Noe-NoserYoung/uek216/uek216/docs/verdrahtung.png

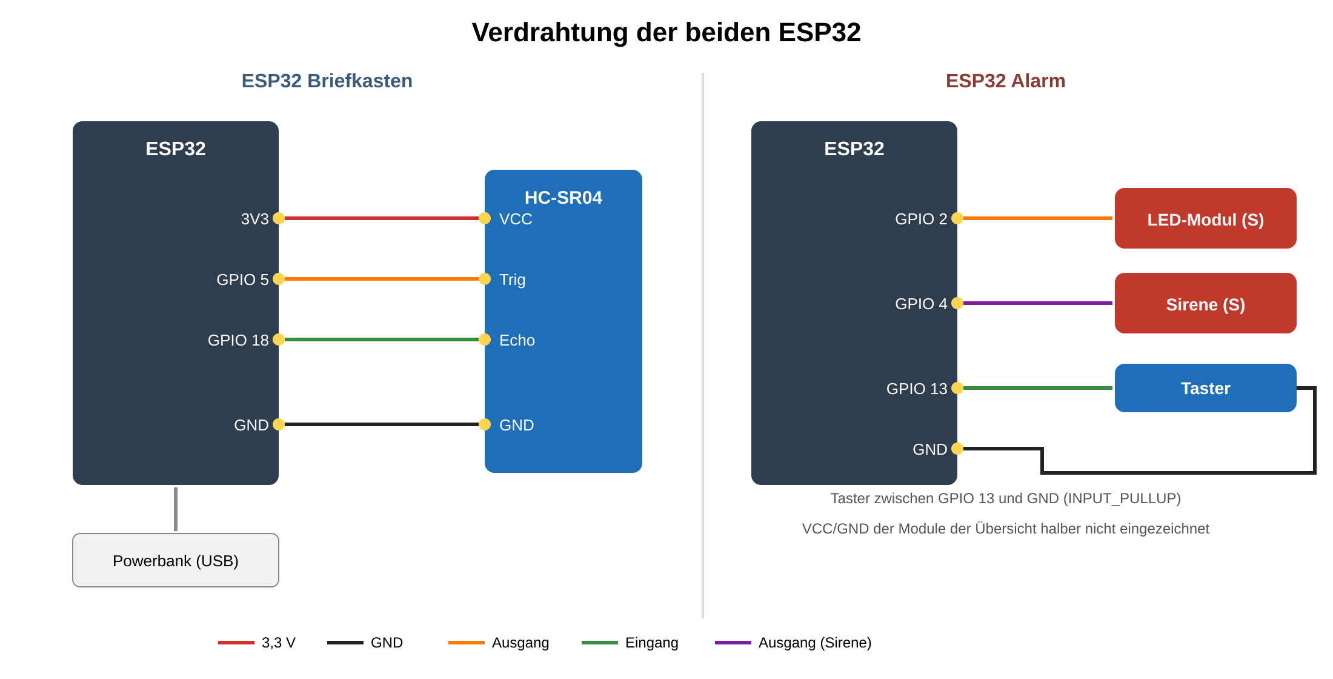
uek216/docs/verdrahtung.png
